fsb2021/water-monitoring-system/app-code/assets/images/bug.jpg

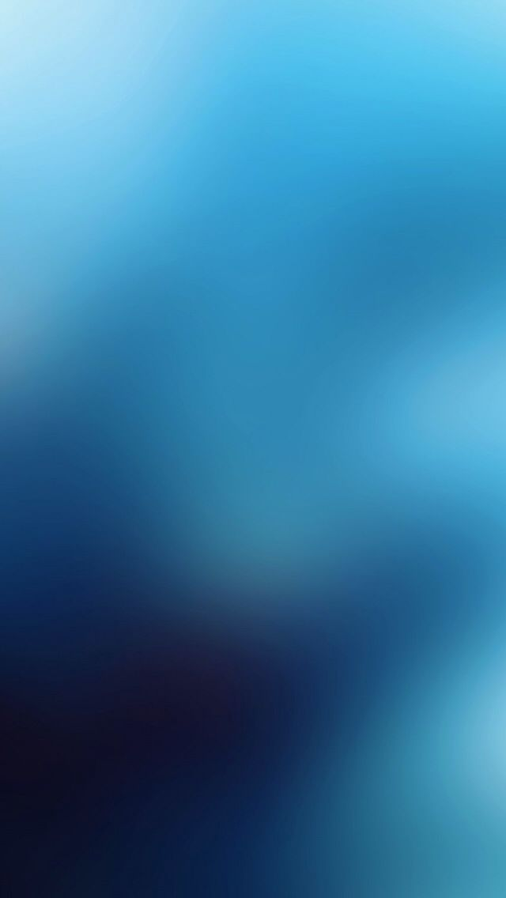
app-code/assets/images/bug.jpg
