fsb2021/water-monitoring-system/architecture-systeme.png

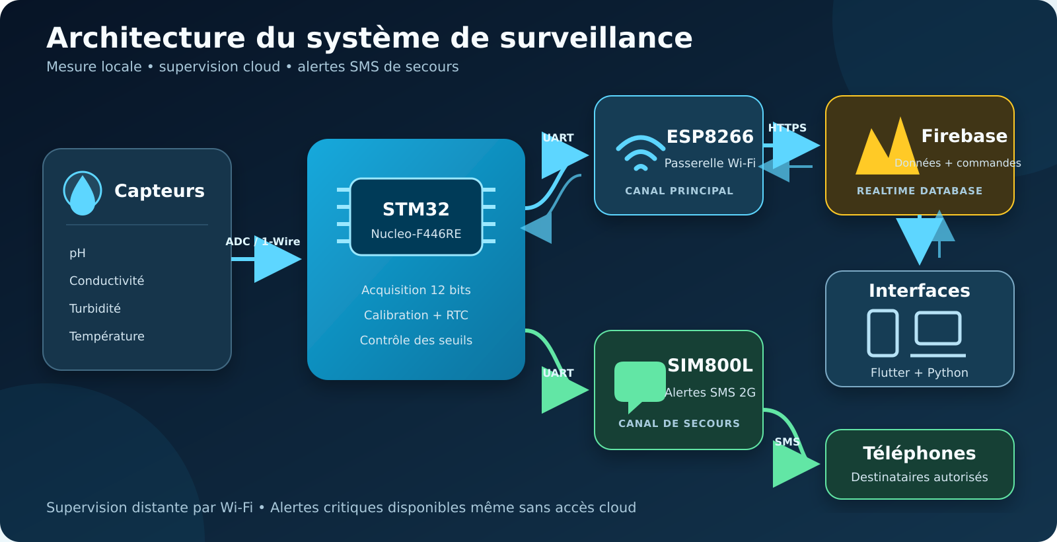
architecture-systeme.png
