fsb2021/water-monitoring-system/app-code/assets/images/12.8.png

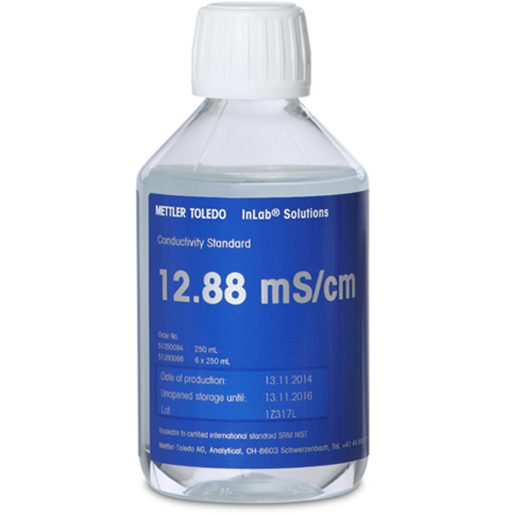
app-code/assets/images/12.8.png
