fsb2021/water-monitoring-system/app-code/assets/images/1413 Scm.jpg

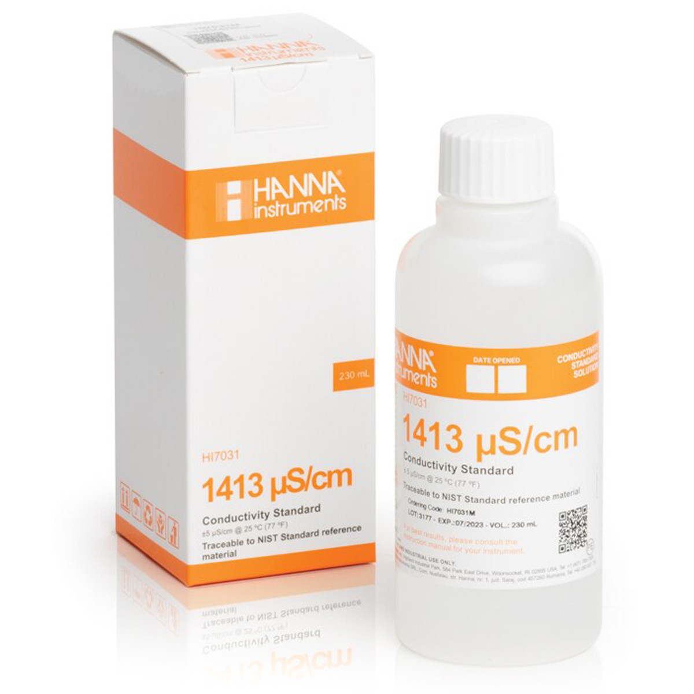
app-code/assets/images/1413 Scm.jpg
