fsb2021/water-monitoring-system/app-code/assets/images/bg.jpg

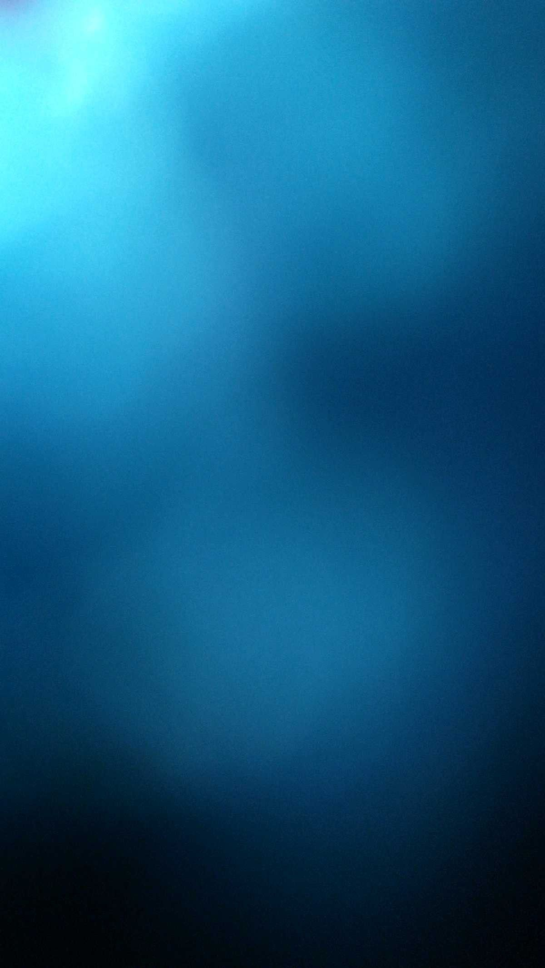
app-code/assets/images/bg.jpg
