fsb2021/water-monitoring-system/app-code/assets/images/ecd.png

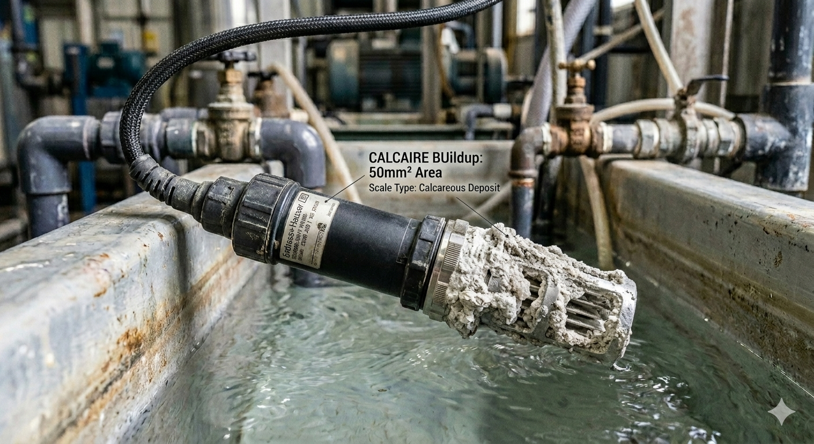
app-code/assets/images/ecd.png
