fsb2021/water-monitoring-system/app-code/assets/images/phc.webp

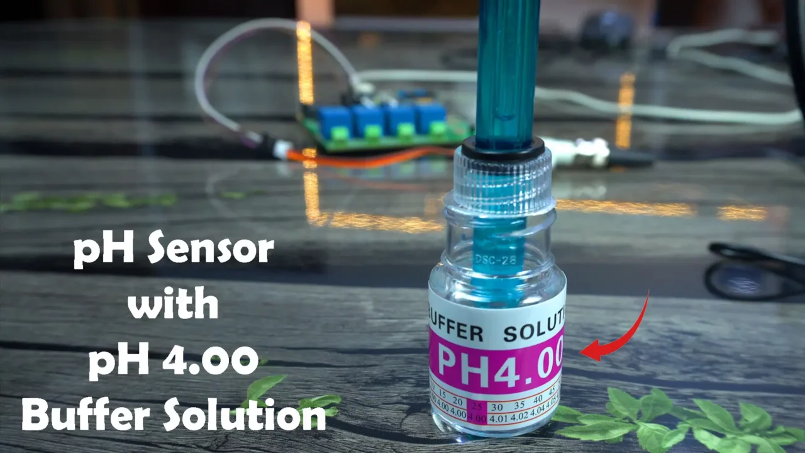
app-code/assets/images/phc.webp
