fsb2021/water-monitoring-system/branchement-systeme.png

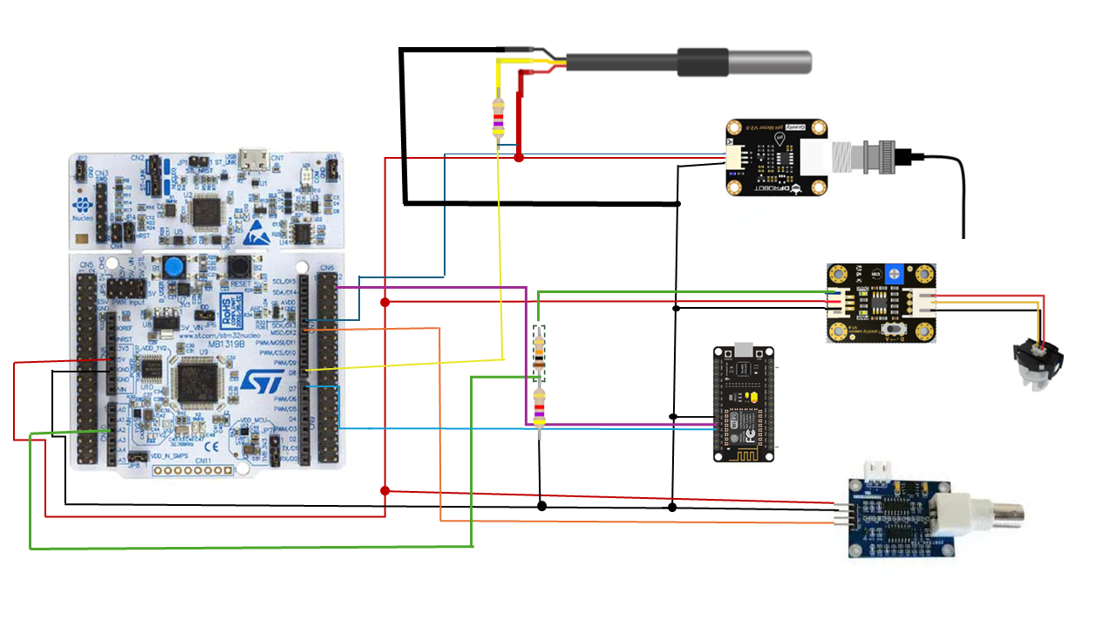
branchement-systeme.png
