fsb2021/water-monitoring-system/(commit log)

2026-08-20 Create stm32
2026-08-20 Update stm32
